BitElectronics/SumoBot/README.md

# SumoBot
Sumo robot with Arduino nano  and 4 side sensors
Uses DRV8835 motor driver and 2S battery.
