BitElectronics/SumoBot/SumoBot.pdf

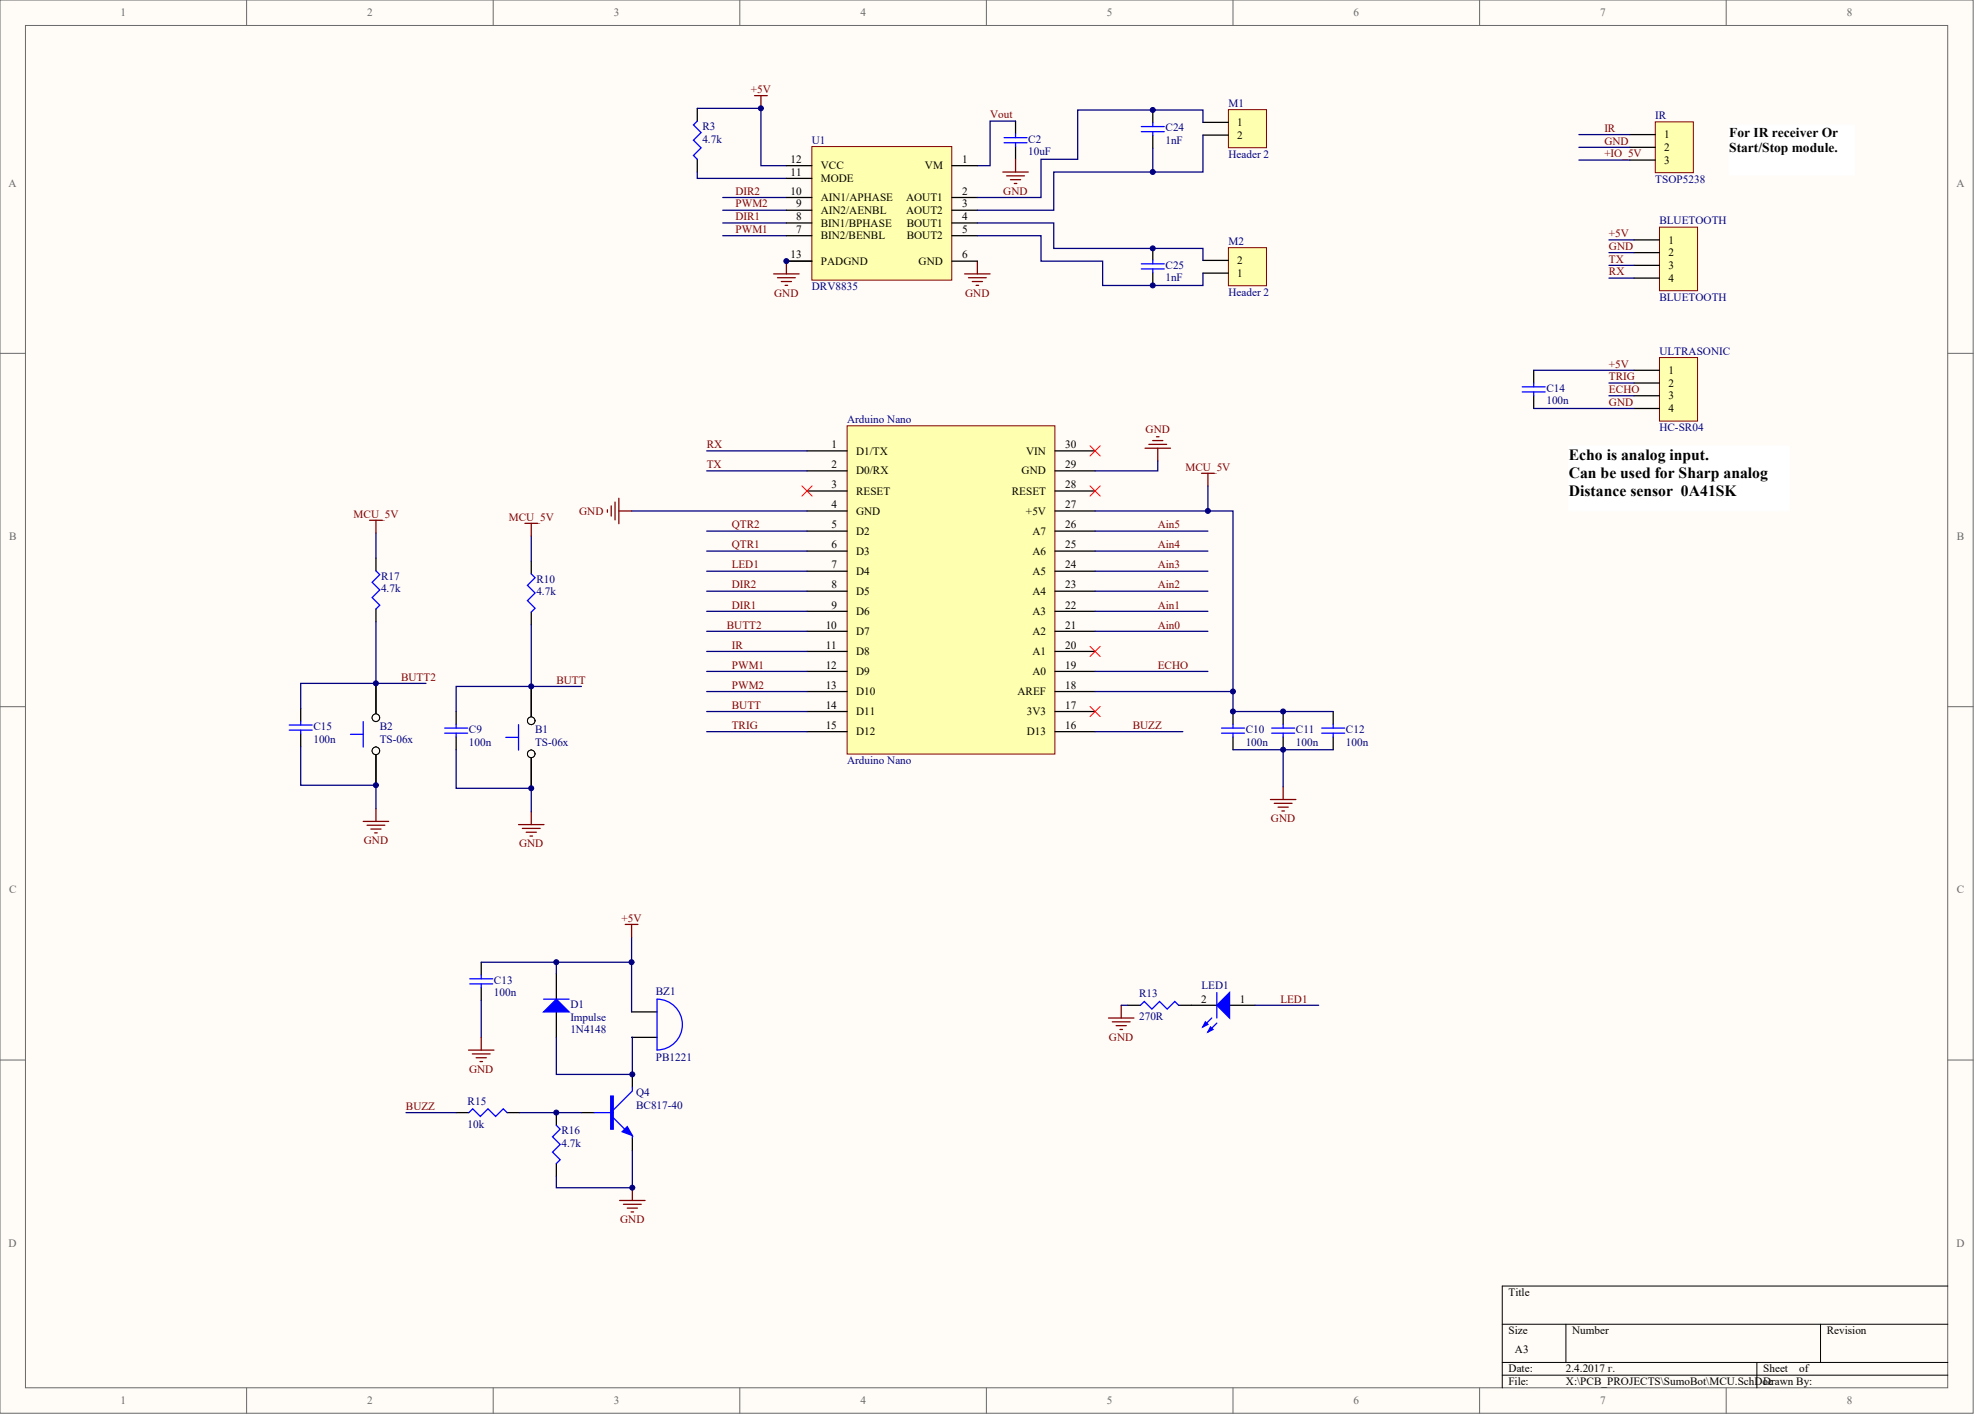
[picture p1: page 1]

For IR receiver Or
Start/Stop module.

Echo is analog input.
Can be used for Sharp analog
Distance sensor 0A41SK

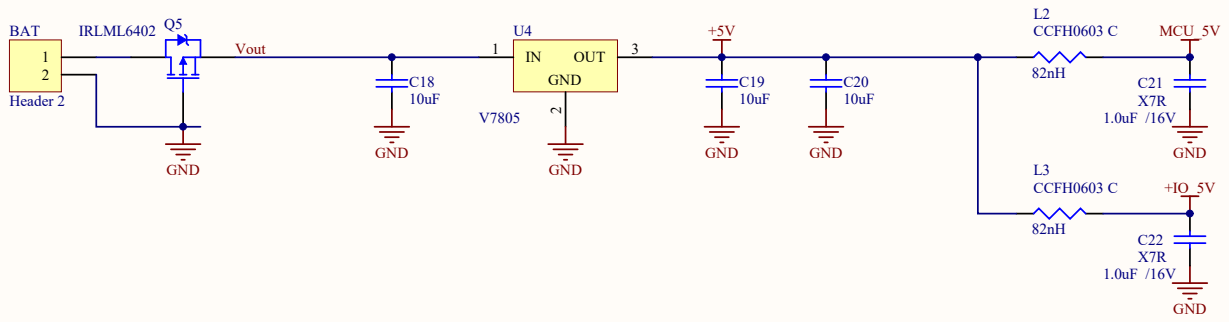
[picture p2: page 2]

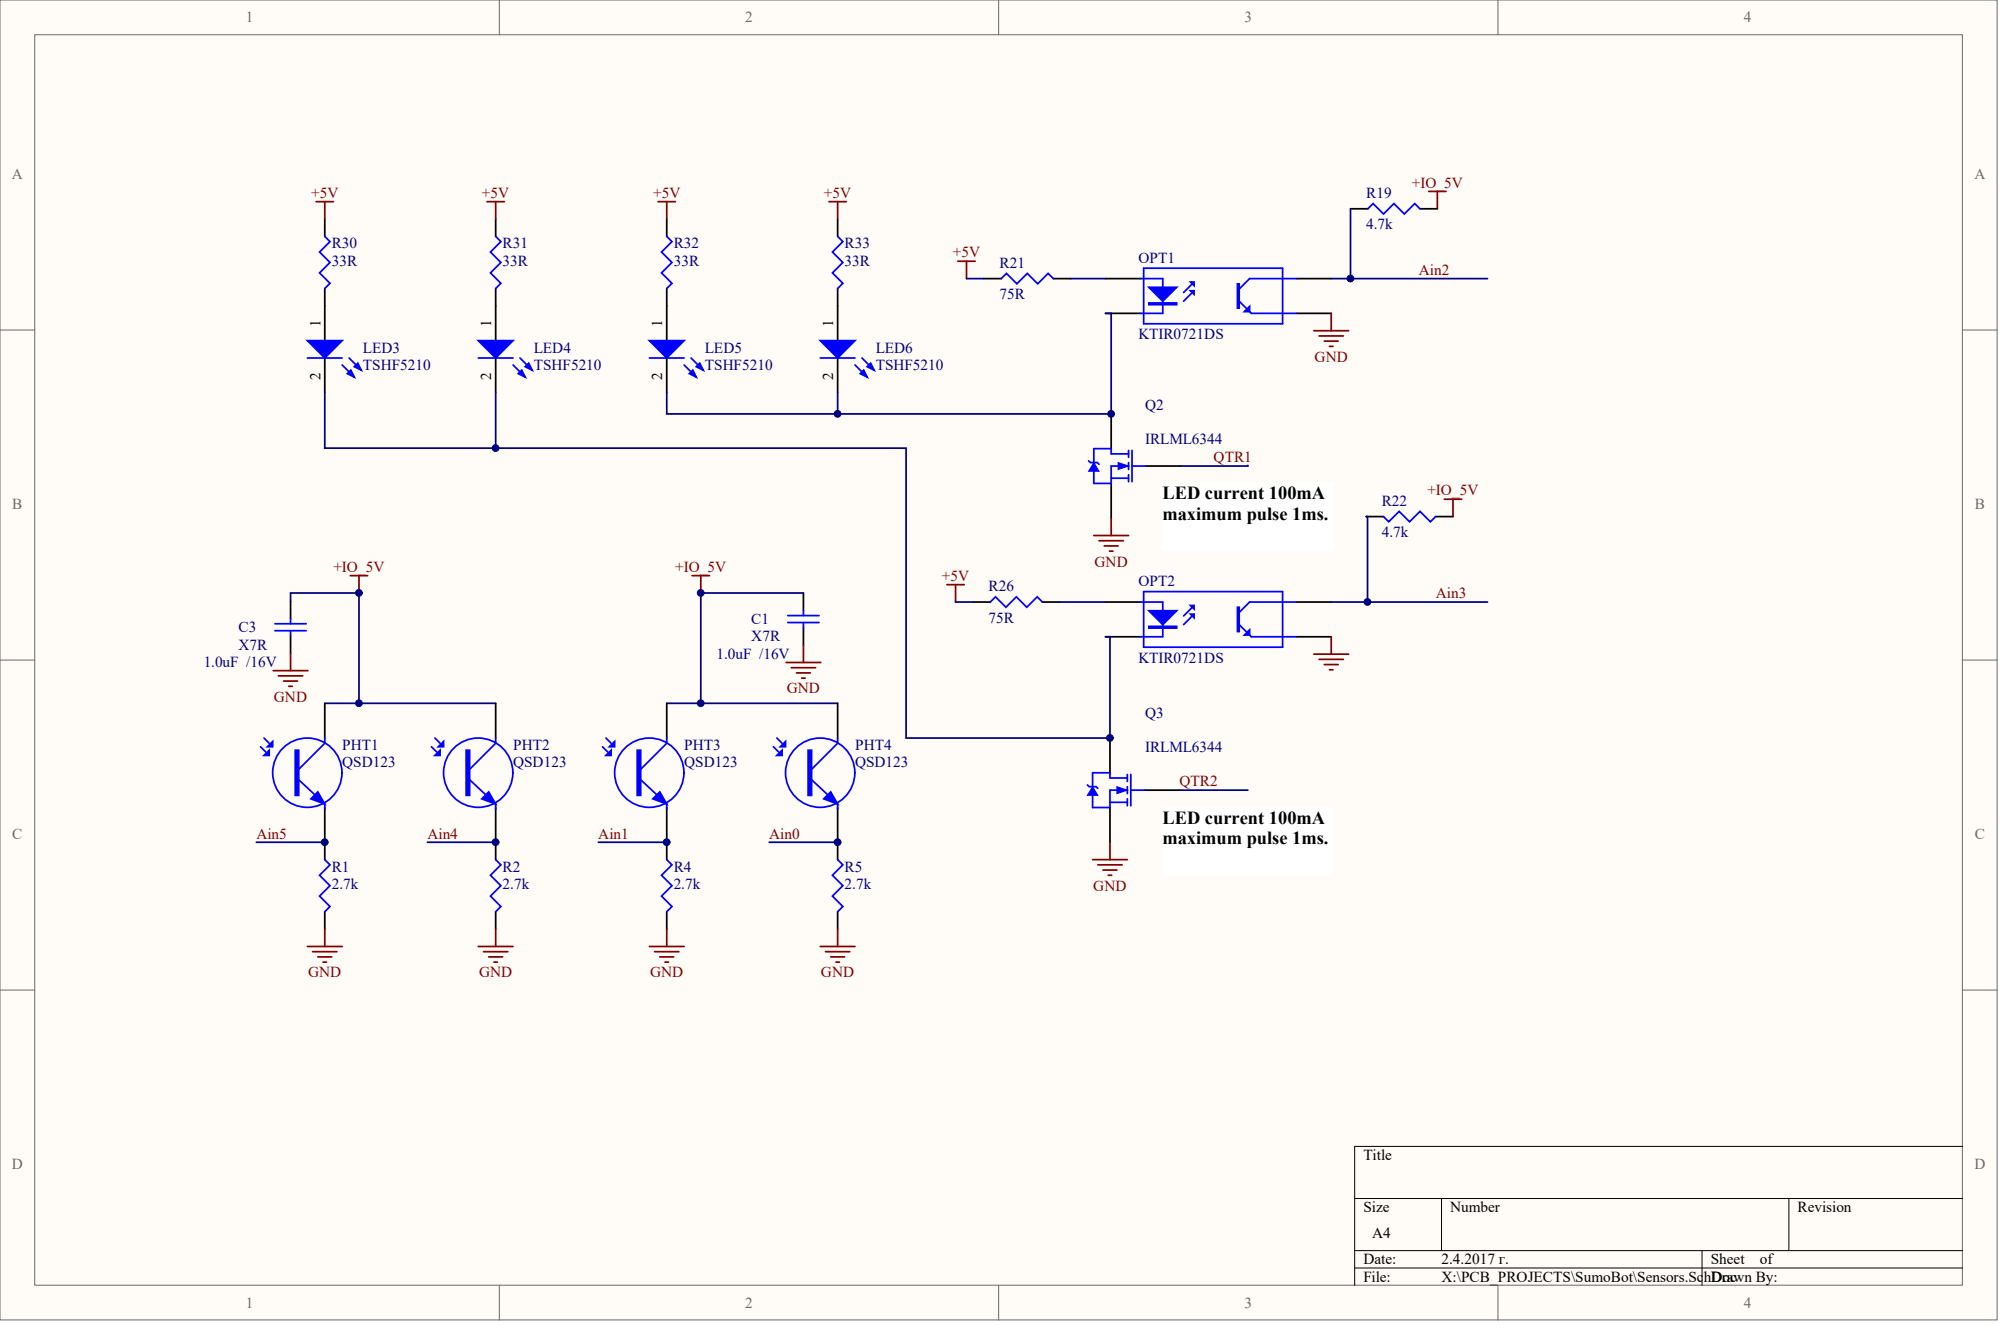
[picture p3: page 3]
